pewpil/auris/docs/hw-comparison.md

---
id: hw-comparison
aliases: []
tags: []
---
# Cane — Hardware branch comparison (esp32-s3 / esp32-p4 / raspi-5 / raspi-4)

> **Derived from the four branch tips (2026-09-26)** — `esp32-s3` (`b853b5b`), `raspi-5` (`adade7f`), `esp32-p4` (`490a7fc`), `raspi-4` (`76e8797`) — each carrying its own itemized components-and-pricing exercise over the `agnostic` hardware-open baseline (`5b40cb2`). Purpose: give the co-researcher's purchase-approval sign-off ([README §9](../README.md#9-open-items)) a single comparison artifact across **all** decision variables (cost, heat, power, compute, cameras, link, form — the full set of 27 below), with a 1/0/−1 score matrix: **1 = the branch's wearable board performs well on the variable, 0 = neither good nor poor, −1 = performs poorly** — absolute scores, so several boards can earn 1s together on a row. The branch choice itself is part of the sign-off; this matrix is a decision aid, not the decision.
>
> **Dated research artifact — read with three later decisions.** (i) **The wearable was chosen from this matrix** (2026-10-01) and **purchased on 2026-10-03: a Raspberry Pi 5, 8 GB at ₱6,000**, with the class closed and **no alternative board class carried** ([README §3](../README.md#3-hardware) constraint 4; [hardware.md](hardware.md) §4). The esp32-s3, esp32-p4, and raspi-4 columns below are therefore **the decision record, not a menu of what else could be bought** — they explain why this class won, and they are kept for that reason alone. (ii) **The hardware bench phase was dropped** (2026-10-01, [`bench-tests.md`](bench-tests.md)), so the **gate-weighted view in §2 (rows 5, 6, 7, 15) scores risks that are no longer executed as measurements**: the co-residence, latency, and underrun rows are now P2 cycle-budget arguments, and row 2's bench-phase outlay is no longer spent. This is also the strongest argument that dropping the bench was affordable on this class — the Pi 5's advantage on the compute rows is **architectural** (an A76's margin), not an empirical claim a breadboard would have had to confirm. (iii) **The matrix scored a 4 GB SKU while an 8 GB board was bought.** Its cost rows (1, 3) and its N1/N4/N15 supply figures therefore **slightly understate the executed purchase** — 8 GB costs more than the 4 GB the matrix priced. This does not disturb the ordering the matrix produced (the RAM delta is far too small to move a −9 vs +19 gap), and the decision is now settled by purchase rather than by score; it is recorded here so the matrix is not read as a costing of what was actually bought.

**Comparison boundary.** The pointer and both P5-bound one-time blocks are byte-identical across the four tips (the ESP32-S3 pointer kit — devkit, IMU, time-of-flight module, ultra-wideband tag, buttons, earphones — plus bench infrastructure, harness kits, the printed-marker stock, the carrier-PCB and soldering-service quote lanes). Every difference priced or scored below is the **wearable side**: its compute board, cameras, audio path, and worn power chain.

## 1. Notes table — the facts each matrix score is grounded in

| # | Fact | ESP32-S3 branch | ESP32-P4 branch | Raspberry Pi 5 branch | Raspberry Pi 4 branch |
|---|---|---|---|---|---|
| N1 | Wearable compute chip | ESP32-S3-DevKitC-1, N16R8: 2 cores at 240 MHz (LX7) + vector instructions, 8 MB PSRAM, radio on-chip | ESP32-P4 Function-EV-Board: 2 cores at 400 MHz (RISC-V) + vector instructions, up to 32 MB PSRAM, ESP32-C6 companion module on-board | Raspberry Pi 5, 4 GB RAM: 4 cores at 2.4 GHz (Cortex-A76), runs Linux — **the variant this matrix scored** (4 GB is ample for the wearable's resident workload: two QVGA CV streams, the renderer, the AP, and batch-written logs sit well under ~1 GB; no swap configured). **The board actually purchased (2026-10-03) is the 8 GB SKU of this same class at ₱6,000** — a superset, so this row's compute verdict carries over unchanged while its cost figures do not (see the header note) | Raspberry Pi 4 Model B, 4 GB RAM: 4 cores at 1.5 GHz (Cortex-A72), runs Linux |
| N2 | Software class | microcontroller, no operating system | microcontroller, no operating system | full Linux single-board computer | full Linux single-board computer |
| N3 | Whole-project fixed-price envelope (each branch's committed totals, as scored 2026-09-26 — **not the executed spend**; the actual cart is ≈ ₱21,800–37,300 with ₱6,000 spent, [`purchase-list.md`](purchase-list.md) §9) | ₱9,750–18,150 | ₱11,800–20,450 | ₱23,800–38,500 | ₱15,400–26,600 |
| N4 | Wearable-core cost inside that envelope (board + cameras + audio) | ~₱940–1,590 (second devkit + three OV2640 modules + amp pair) | ~₱4,300–6,700 (evaluation board + three MIPI camera modules + flat-cable spares + amp pair) | ~₱14,000–20,800 (Pi + two Camera Modules 3 Wide + cables + cards + audio sticks) | ~₱6,800–10,500 (Pi + three IMX219 160° modules + cable spares + mandatory heatsink + cards + audio sticks) |
| N5 | Mobile power chain (worn) | protected 18650 cell on a charging/protection board (rear station) | compact 10,000 mAh power bank, 5 V / 2 A out | USB power-delivery bank ≥ 20,000 mAh / 45 W + a 5 V/5 A trigger board + 5 A-rated cables; official 27 W mains supply for the bench only | standard bank, 5 V / 3 A out, ≥ 10 Ah; official 15 W mains supply for the bench only — **no trigger board, no e-marked cables** |
| N6 | Typical sustained draw, render + tracking active | under ~1.5 W | roughly 2–4 W | roughly 5–12 W (the 8 GB SKU sits at the top of this range on memory-side activity; **verify actual draw at the P2 SPICE step and record it**, since runtime on the worn bank depends on it) | roughly 4–6 W |
| N7 | Runtime per charge (worst-case math from each branch's own rows) | 9 Wh cell at ~1 W, duty-cycled → many hours | 37 Wh bank at ~3 W → 10 h + | 74 Wh bank at ~8 W → ~8 h, on the branch's biggest bank | 37 Wh bank at ~5 W → ~6–7 h |
| N8 | Thermal class at the head | cool, no heatsink | warm, no heatsink (larger board area spreads it) | wants a heatsink/active cooler near skin | **heatsink mandatory** (the A72 throttles readily under sustained all-core load) |
| N9 | Boot to first sound | well under a second | well under a second | tens of seconds (Linux boot) plus crash/freeze modes the branch itself flags | tens of seconds (Linux boot) — same Linux class |
| N10 | Camera ports on the board | one (parallel DVP) → cameras alternate; multiplexer question open at the tracking gate | one (MIPI serial lane) → cameras alternate; multiplexer question reopened at the tracking gate | two native MIPI lanes → mux question closed in hardware | one 15-pin MIPI lane → cameras alternate; multiplexer question reopened at the tracking gate |
| N11 | Pinned cameras | OV2640, 160° field of view, ~₱100–200 each, stocked everywhere local | SC2336-class MIPI modules, ~₱300–900 each, fewer local stockists, lens-variant checkout caution | Camera Module 3 Wide official, 120°, autofocus — ₱1,500–3,000 each; distributor currently showing sold-out under a global supply advisory | IMX219 160° modules, ₱500–900 each, multiple confirmed local listings; visible-light only — NoIR/night-vision variants rejected |
| N12 | Radio / link | native Wi-Fi on-chip; link = ESP-NOW (native, no accessory) | no radio on the chip — the on-board C6 companion hosts the access point; data crosses an esp_hosted hop | native Wi-Fi; hosts the access point through Linux networking | native Wi-Fi; hosts the access point through Linux networking |
| N13 | Audio path | two I²S class-D amplifiers → wired jack (literal hardware path) | identical literal I²S path | USB dongle → jack (kernel audio stack in the path) | USB dongle → jack — **the board's native analog jack exists but is deliberately declined** (PWM-derived, hiss/limited SNR) |
| N14 | Board size / on-head mass class | devkit ~25×55 mm; wearable well under ~200 g all-in | evaluation board ~100×70 mm + bank → ~300 g class | 85×56 mm + active cooling + biggest bank → ~450 g+ class | 85×56 mm + heatsink + bank → ~300 g class |
| N15 | Supply-lane health (each branch's own words) | confirmed in stock locally (₱499 devkit) | listed locally but single-shop risk flagged | **resolved by purchase** — the row recorded distributor sold-out at ₱11,449 with a price/lead-time advisory, and the board was in fact obtained locally on 2026-10-03 at **₱6,000** (consistent with a grey import, **no manufacturer warranty**, so the supply risk that remains is DOA replacement rather than availability) | well stocked locally (Circuitrocks same-day Metro Manila, Makerlab, Shopee kits) — listings carry the same global advisory wording |
| N16 | Tracking-tier software stack (camera frames → quad detection → pose solve) | esp32-camera frames; **no OpenCV on ESP-IDF** — the quad detector and pose solve are hand-implemented in C; the ecosystem's nearest stock precedent is a QR-code example (finder-pattern logic, not a fiducial pipeline); the plan's fallbacks (flexible dictionary, detect-then-track) are named mitigations | esp_cam_sensor/ISP frames; **same hand-built detector situation** — no stock fiducial library on ESP-IDF; vector instructions accelerate the inner loops but the code is equally custom | picamera2/legacy frames; **stock `cv2.aruco`** (opencv-contrib) and mature AprilTag libraries — the plan's exact pipeline as standard function calls | picamera2 frames; **stock `cv2.aruco`** — identical library story, with more headroom already counted in row 5 |

## 2. The score matrix (1 performs well / 0 neither / −1 performs poorly)

| # | Variable | ESP32-S3 | ESP32-P4 | RPi 5 | RPi 4 |
|---|---|---|---|---|---|
| 1 | Whole-project cost envelope | 1 | 0 | −1 | 0 |
| 2 | *(retired 2026-10-01)* Formerly "bench-phase outlay — parts that must land before the breadboard phase." **No bench phase runs**, so this row scores a decision nobody has to make any more; kept for the record, it is **excluded** from the column sums' gate-weighted reading | 1 | 0 | −1 | 0 |
| 3 | Wearable-core part cost | 1 | 0 | −1 | 0 |
| 4 | Supply stability on branch-critical rows | 1 | 0 | −1 | 0 |
| 5 | Compute headroom at the render + tag-detection co-residence gate | 0 | 1 | 1 | 1 |
| 6 | Motion-to-sound latency certainty (the 100 ms budget's audio path) | 0 | 1 | −1 | −1 |
| 7 | Render underrun risk (≤ 2 ms per 128-sample audio buffer) | 0 | 1 | −1 | −1 |
| 8 | Boot-to-first-sound time and run reliability | 1 | 1 | −1 | −1 |
| 9 | Heat near the user's head at sustained load | 1 | 1 | −1 | −1 |
| 10 | Thermal-design burden on the printed build | 1 | 0 | −1 | −1 |
| 11 | Mobile-rail weight and bulk on the strap | 1 | 0 | −1 | 0 |
| 12 | Session runtime between charges | 1 | 1 | 0 | 0 |
| 13 | Power-rail complexity | 1 | 1 | −1 | 1 |
| 14 | Recharge turnaround and spare-supply logistics | 1 | 0 | −1 | 0 |
| 15 | Camera capture architecture (ports; mux exposure) | −1 | −1 | 1 | −1 |
| 16 | Camera module price and local availability | 1 | 0 | −1 | 1 |
| 17 | Camera field-of-view fit for the vision tier | 1 | 0 | 1 | 1 |
| 18 | Camera software and driver maturity | 1 | 0 | 1 | 1 |
| 19 | Audio path simplicity and fidelity | 1 | 1 | −1 | 0 |
| 20 | Link implementation risk on the branch's own stack | 1 | −1 | 0 | 0 |
| 21 | Link throughput headroom | 0 | 1 | 1 | 1 |
| 22 | Total on-head weight | 1 | 0 | −1 | 0 |
| 23 | Breadboard-friendliness under the no-solder rule | 1 | −1 | 0 | 0 |
| 24 | Hand-solder carrier fit for the outsourced soldered build | 1 | 0 | 0 | 0 |
| 25 | Fit in the strap-mounted wearable form | 1 | 0 | −1 | −1 |
| 26 | HRTF rendering capacity and quality-building headroom | 0 | 1 | 1 | 1 |
| 27 | Pointer-tracking (ArUco/AprilTag) detection-software readiness on the branch's own stack | 0 | 0 | 1 | 1 |
| | **Column sums** | **+19** | **+7** | **−9** | **+1** |

Gate-weighted view — doubling the four rows where a bench gate can actually fail (rows 5, 6, 7, 15): **ESP32-S3 +18, ESP32-P4 +9, RPi 5 −9, RPi 4 −1** (row 27 stays single — doubling it would re-count row 5's content). The ordering is stable under both weightings (S3 > P4 > RPi 4 > RPi 5). Worth saying out loud: the raspi-4 branch is the only one whose gate-weighted score falls *below its own unweighted score* — from +1 to −1 — while the S3 barely moves (19 → 18), the P4 rises (7 → 9), and the RPi 5 is unchanged (−9 → −9): four of the Pi 4's weaknesses sit directly on gate-touching rows (latency, underruns, the reopened mux, and heat feeding the thermal gate), and its two native-camera-port advantage is absent — at a much lower price than the RPi 5, but the price advantage does not convert into gate safety.

## 3. Explanation of each variable

1. **Whole-project cost envelope** — each branch's committed fixed-price total from its purchase list (notes row N3). Scored by where the envelope sits, not by a relative race: S3's sits comfortably low (+1), the P4's and the Pi 4's are reasonable middles (0 each — the Pi 4 clearly above the P4, both clearly below the S3), the Pi 5's is more than double the S3's (−1). *Post-purchase note (2026-10-03): the executed cart is ≈ ₱21,800–37,300 with the compute board bought at ₱6,000, so the envelope as actually spent sits **below** this scored range at the low end — the −1 still stands as the matrix's judgement of the class on 2026-09-26, but it should not be read as a costing of what was bought.*
2. **Formerly "bench-phase outlay" (retired 2026-10-01)** — what must be spent up front for the breadboard phase. With no bench phase this row is **historical**: the scored ordering (a ₱500 devkit well, the Pi 5's 45 W supply-class kit poorly) remains a true statement about up-front outlay under a hardware-first plan, but the project no longer runs one. Recorded, not used.
3. **Wearable-core part cost** — the only part of the bill that differs by branch (notes N4). Same scoring logic: the microcontroller-class cores score well or neutral; the Pi 4's ~₱6.8–10.5k is half the Pi 5's but 4–5× the S3's → 0.
4. **Supply stability** — how risky the branch-critical rows are to buy today under the plan's local-lane purchasing rule: S3 confirmed in stock locally (+1); P4 listed but its own document flags single-shop risk (0); the Pi 5's official distributor is currently showing sold-out with an explicit supply advisory (−1); the Pi 4 is genuinely well stocked on multiple local lanes, with only boilerplate advisory wording → 0. *Post-purchase note (2026-10-03): the Pi 5's −1 was **resolved in fact** — the board was obtained locally at ₱6,000 — but it converted into a different exposure: a grey import carries **no manufacturer warranty**, so the residual risk is DOA replacement rather than availability ([README §3](../README.md#3-hardware) constraint 3, [§7](../README.md#7-risks-and-limitations) risk 12).*
5. **Compute headroom at the co-residence gate** — the Phase 2 bench test 7 makes the audio renderer and the camera-vision pointer tracker share one chip. S3: expected to pass, but the margin is exactly what the plan's risk 8 worries about → 0. P4 (400 MHz, up to 32 MB PSRAM), R5 (Linux + OpenCV-class compute), and the Pi 4 (4× A72 + Linux) all carry genuinely comfortable margins (+1 each). The detection-software dimension is separated into row 27; this row stays on raw margin.
6. **Motion-to-sound latency certainty** — the plan's absolute 100 ms motion-to-sound target, of which ≤ 2 ms is the per-audio-buffer render row. S3: literal hardware path, but the margin must be proven on the bench — scored 0 (unguaranteed, unthreatened). P4: literal path and more margin → 1. R5 and the Pi 4: a kernel scheduler sits in the audio path — the raspi-5 branch names Linux audio jitter as its real exposure, and the raspi-4 branch inherits exactly the same Linux class → −1 each.
7. **Render underrun risk** — the same render row from the failure side: buffer underruns make the sound stutter. Scoring mirrors row 6 for all four branches.
8. **Boot and run reliability** — participants in the Phase 5 study put this on their heads: S3 and P4 power on into the sound in under a second with no operating system to freeze (+1 each); both Pi branches take tens of seconds and introduce crash/silent-failure modes → −1 each.
9. **Heat at the head** — sustained render + camera load next to skin. Both microcontroller-class boards run cool without heatsinks (+1 each); both Linux boards want cooling near the user's face — the Pi 4 most of all, since its branch makes the heatsink mandatory outright → −1 each.
10. **Thermal-design burden on the printed build** — how much the enclosed, service-soldered Phase 3 housing must engineer airflow: none needed for S3 (+1); mild vent/area planning for the bigger P4 board (0); deliberate thermal design for both Pi branches — the raspi-4 branch's own text calls it a stronger duty than the raspi-5's A76 → −1 each.
11. **Mobile-rail weight and bulk** — the worn supply's mass: small protected cell (+1); pocket banks on P4 and Pi 4 (0 each); a delivery-grade 45 W bank plus trigger board and heavy-rated cables on the Pi 5 (−1).
12. **Session runtime** — stored energy versus draw: S3's small cell with duty-cycled draw lasts long (+1); P4's bank dwarfs its gentle draw (+1); both Pi branches net out ordinary — the Pi 5 from a very large bank against a heavy draw (0), the Pi 4 from a mid bank against a mid draw (0).
13. **Power-rail complexity** — how many negotiated-contract/delicate-cable mechanisms sit between battery and chip: S3's protected-cell chain (+1); P4's plain 5 V bank feed (+1); the Pi 4's plain 5 V/3 A contract — the branch's own words: the raspi-5 branch's most tangled block simply does not exist here (+1); the Pi 5's 5 V/5 A contract, which fails into throttling and needs a power-delivery trigger board and e-marked 5 A cables → −1.
14. **Recharge turnaround** — S3's small cell recharges quickly and cheaply to duplicate (+1); P4's swappable bank and the Pi 4's swappable bank (0 each); the Pi 5's multi-hour 20,000 mAh bank recharge (−1).
15. **Camera capture architecture** — how many native camera ports the board has: S3 has one (−1), P4 has one (−1), and the Pi 4 has one (−1) → all three leave the multiplex/alternation decision to the tracking gate at bench test 7, while the Pi 5's two native lanes close the question in hardware (+1). This is the row where the P4's and Pi 4's compute surplus is spent buying back a problem the S3 branch also carries — and on the Pi 4 it is the reopened risk the branch itself flags.
16. **Camera price and availability** — OV2640 modules cost ~₱100–200 each everywhere (+1); SC2336-class is available with fewer stockists and a lens-variant caution (0); the official Camera Module 3 Wide is 3–4× the price with shaky distributor stock → −1; the IMX219 160° modules sit at ₱500–900 each across **many confirmed local listings** — the availability term is strong enough to score +1 despite the mid price.
17. **Field-of-view fit** — 160° modules on S3 (+1) and 160° modules on the Pi 4 (+1 — the widest of the four); the P4's pinned sensor class lists narrow lenses by default, wide variants needing checkout care (0); the Pi 5's official 120° wide camera is a clean fit (+1).
18. **Camera software maturity** — the S3's camera driver and detection examples are the most trodden path in the Espressif ecosystem (+1); the P4's sensor support is in-tree but newer (0); on the Pi side the IMX219 is the longest-supported Raspberry Pi camera — mature drivers and a decade of examples (+1), and the Pi 5's official stack is likewise mature (+1).
19. **Audio path simplicity** — S3 and P4 both take the plan-native literal digital-audio-into-amplifier route into the mandatory wired jack (+1 each); the Pi 5's USB-dongle detour is **forced** (no analog output exists) → −1; the Pi 4's dongle path is a **consciously chosen** detour — the board's native jack exists and is declined for signal-to-noise and cross-branch consistency, so the fidelity term is fine and the complexity is a deliberate, documented trade → 0.
20. **Link implementation risk** — S3's ESP-NOW is native and abundant in examples (+1); the P4's answer — an on-board companion chip bridged by esp_hosted glue — is functional but is exactly the hop its own document flags for verification (−1); both Pi branches run the standard Linux access-point pattern, unremarkable (0 each).
21. **Link throughput headroom** — ESP-NOW suits today's small payloads but little more (0); the Wi-Fi-6 companion (+1) and both full Linux network stacks (+1, +1) leave room to grow.
22. **Total on-head weight** — the wearer carries everything: S3 well under ~200 g (+1); P4 and Pi 4 land in the ~300 g class with their banks (0 each — the Pi 4 trades the P4's big board for its heatsink); R5 goes past ~450 g with its cooler and biggest bank (−1).
23. **Breadboard-friendliness** — the Phase 2 rule forbids soldering: the S3 devkit is all header rows (+1); the P4 evaluation board is connector-saturated (serial-camera and flat-flex interfaces dominate) → −1; both Pi branches expose a 40-pin header workable with common cobbler adapters (0 each).
24. **Hand-solder carrier fit** — the Phase 3 build is outsourced to a local hand-solder service with carrier boards designed through-hole-dominant ([`assembly.md`](assembly.md) binds this): the S3 fits that bind perfectly (+1); on P4, R5, and the Pi 4 the compute board itself is a connector-saturated module that mounts as a unit, and the flat-flex/ribbon camera world sits at the edge of what a hand-solder shop wants — the harness work still applies to all four, but the carrier story is simplest on S3 (0, 0, 0).
25. **Strap-form fit** — the resolved form factor is an elastic strap with printed mounts, not a helmet: a credit-card-plus devkit vanishes into a mount (+1); the P4's evaluation board rides mid-strap, bulky but practical (0); both Pi boards are 85×56 mm slabs — the Pi 5 plus cooler plus the biggest bank is the least consistent with the form (−1), and the Pi 4 plus mandatory heatsink repeats the same structural mismatch with a lighter bank (−1).
26. **HRTF rendering capacity and quality-building headroom** — spatialized rendering is the product (`renderer`: generic HRTF azimuth, 48 kHz buffers under the ≤ 2 ms-per-buffer row), and the plan deliberately keeps the workload modest (elevation is carried by the carrier-pitch cue, not spectral HRTF — the plan's risk 3). All four run the planned HRTF; this variable scores what the chip can afford **beyond** that while sharing duty with vision: longer impulse responses and denser azimuth grids (the real levers on rendering quality), and eventually per-participant measured HRTF sets. S3: planned route fits inside the budget, but upgrade headroom while co-residing with detection is bounded, and measured-HRTF work is out of its class → 0. P4: vector instructions plus PSRAM tables afford longer filters and denser grids alongside CV duty (+1). Both Pi branches: CPU to burn for research-grade binaural work (+1 each). This is the one row where branch choice most directly touches the study's perceptual outcomes (the localization metrics) — a genuine plus for the three high-compute branches even though the thesis plan specifies the modest, robust route; worth putting before the co-researcher at sign-off rather than burying.
27. **Pointer-tracking (ArUco/AprilTag) detection-software readiness** — the vision tier's path from camera frames to quad detection to the pose solve that turns the printed marker's known physical size into bearing and range ([README §2.5](../README.md#25-pointer-tracking-stack-vision-uwb-imu), [§3.8](#38-pointer-tracking-hardware--notes--contingencies)). The row deliberately does **not** re-score raw compute margin (row 5), camera port count (row 15), or capture-driver maturity (row 18) — it isolates the one thing they do not say: whether the tracker is a library call or hand-built engineering. S3 and P4: no OpenCV exists on ESP-IDF, so the quad detector and the pose solve are hand-implemented in embedded C — the ecosystem's nearest stock precedent is a QR-code example (finder-pattern logic, not a fiducial pipeline); feasible, and the plan's own designed route (the marker decision explicitly moved the cost from hardware to compute), but custom engineering that must land inside the co-residence budget → 0 each; scoring S3 lower than P4 here would double-count row 5's margin. Both Pi branches: `cv2.aruco` (opencv-contrib) and mature AprilTag libraries make the plan's exact pipeline standard function calls on `picamera2` frames → +1 each. The row's honest message: **on the two Linux branches the vision tier is configuration; on the two microcontroller branches it is a build item** — where the tier's schedule risk lives before the pre-oral defense, mitigated by the plan's named fallbacks (flexible dictionary choice, the detect-then-track scheme, QVGA mono frames) rather than eliminated.

## 4. Reading the result

- **Unweighted: ESP32-S3 +19, ESP32-P4 +7, Raspberry Pi 4 +1, Raspberry Pi 5 −9.** Gate-weighted (rows 5, 6, 7, 15 doubled; row 27 single): **S3 +18, P4 +9, RPi 4 −1, RPi 5 −9** — the ordering survives both weightings, with one nuance: gate-weighting *lowers* the Pi 4 below zero (four of its weaknesses sit on gate-touching rows) while leaving the Pi 5 unchanged (its two native camera ports buy back one gate row), so the two Linux branches converge under stress — the Pi 4's price advantage does not convert into gate safety.
- **The tracking tier's software dimension is now explicit (row 27)**: on the two Linux branches the ArUco/AprilTag pointer tracker is a stock library call; on the two microcontroller branches it is a hand-built detection-and-pose pipeline (no OpenCV on ESP-IDF) that must be validated inside the co-residence gate — the strongest single argument for the high-compute branches once the HRTF row is on the table, with the plan's named fallbacks (flexible dictionary, detect-then-track, QVGA mono frames) mitigating rather than eliminating that schedule exposure.
- The corrected scoring semantics sharpen the story: the S3 leads not because the P4 is bad — its co-residence, heat, runtime, audio, power-simplicity, and HRTF-headroom scores are all genuinely +1 — but because the S3 wins or ties on nearly everything while being the cheapest at the head and in the pocket. The P4's honest deficit list is short and specific: one camera port, the companion-chip link hop, flat-cable-heavy bench ergonomics, thin supply lanes. The raspi-4 branch nets to exactly zero — it inherits the Linux class's structural costs (kernel-in-the-audio-path, heat with a mandatory heatsink, boot exposure, the single camera port, the slab form) while shedding the Pi 5's power-rail complexity and a third of its price, and it buys back camera availability with the IMX219 pair — the trade is real, but it nets to neither good nor poor. The Raspberry Pi 5's deficits — power, heat on the head, weight, boot/latency exposure, price — remain structural to the computing class, which is exactly what a head-mounted device cannot buy back with headroom.
- The matrix is a prior, not a verdict — and the referee changed shape twice: the bench gates it weighted (render tests, tracking co-residence) are no longer executed as measurements, so the chosen board is defended on **architectural** margin plus P4/P5 in-use observation; and the board is now **purchased** — the **Raspberry Pi 5, 8 GB** wearable (bought 2026-10-03, ₱6,000; [README §3](../README.md#3-hardware), [§9](../README.md#9-open-items)), with the class closed and **no alternative carried** ([`hardware.md`](hardware.md) §4). The matrix scored a 4 GB SKU, so its cost rows understate the actual spend by the 8 GB delta. Prices were point-in-time and the ultra-wideband module's single-shop risk applies to all four equally, so it scores nowhere.

## 5. Provenance and upkeep

Derived read-only from the committed state of the four branch tips on 2026-09-26 (`esp32-s3` @ `b853b5b`, `raspi-5` @ `adade7f`, `esp32-p4` @ `490a7fc`, `raspi-4` @ `76e8797`, baseline `agnostic` @ `5b40cb2`); scores are judgments over those tips' committed purchase lists and README selections, not new facts. Row 27 is scored from the same tips — the tracking design (the marker scheme, [README §2.5](../README.md#25-pointer-tracking-stack-vision-uwb-imu)) is plan-level text identical across them, so no tip change accompanies that row. If a branch tip changes (prices re-verified, a part swapped), re-derive the affected rows from that tip and bump the date here. The matrix is the standing scoring basis behind the **decision** (the purchased Raspberry Pi 5, 8 GB wearable) and is refuted only by observation on the built device (P4/P5), never superseded by a paper decision — and, since the 2026-10-03 purchase, not by a re-costing either. Any tip-priced row is re-verified at checkout under the current purchase lanes ([README §9](../README.md#9-open-items)).
