pewpil/auris/.opencode/concept.md

# Cane — Concept

The canonical concept statement lives in the project [`README.md`](../README.md) — [§1 Concept](../README.md#1-concept) (user, equipment, and the laser-hit → egocentric-sound interaction rule), with the system architecture in [§2](../README.md#2-system-overview).

Raw requirements and the worked concept examples remain in [`new.md`](new.md). This stub is session context only and must be kept consistent with `README.md`; edit the README, not this file.
