pewpil/auris/auris/tools/bringup/bringup-log.md

# Raspberry Pi bring-up snapshot

Last confirmed: 2026-11-07 12:01 Asia/Manila. This is a dated observation, not a claim that the hardware state will remain unchanged.

## Working path

The Pi dashboard process `auris.service` is enabled and active on `capstone`; its `/state` endpoint reports `mock: false`. The unit uses `Restart=always`, is wanted by `default.target`, and the user manager has `Linger=yes`, so the local dashboard starts at boot and restarts after process failure. The PC can reach the live endpoint over direct Ethernet at `http://192.168.77.2:8081/state` when requests bind to PC address `192.168.77.1`, with observed fetch times around 60–65 ms.

The pointer path is producing a changing orientation matrix and ToF readings around 1.85 m. The trigger state is readable. Earlier direct requests took around 60–65 ms; the latest local-proxy browser sample took 5.7 ms. The terminal views in this directory show the same live snapshot.

At 01:57, the local Ethernet proxy at `http://127.0.0.1:8781/` returned the dashboard and live state with HTTP 200; the state fetch took 110 ms and reported `mock: false`, ToF 1.853 m, and 55,954 camera frames.

The Pi camera is capturing 640×480 frames. At 02:26 the state counter was 1,503 frames after the service restarted, with zero accepted cube-pose frames and zero read failures. Earlier browser brightness samples were below 1/255, so the current preview has not provided usable tag detections.

At 02:31, the Windows browser showed a live pointer-only snapshot over the Ethernet proxy: ToF 1.852 m, camera 6,948 frames at an estimated 23.2 fps, zero accepted detections, 62.9 ms frame-read time, 2.7 ms detect time, and zero read failures. The browser’s downsampled camera brightness was 0.2/255, so the immediate tracking blocker is an almost-black image rather than slow ArUco processing; the exact cause (cover, aim, exposure, or lighting) is not distinguishable remotely. The page reported no head IMU sample. The stereo-pan display was also corrected locally from a degree-like value to a normalized left/center/right percentage bar.

A read-only watcher was originally started as PID 32815 until approximately 09:50 Asia/Manila, polling `/state` every 30 seconds. At 03:10 it had written 158 snapshots with zero poll errors. Its script is `/home/user/auris_telemetry_watch.py`, output is `/home/user/auris-bringup-watch-20261107.jsonl`, and stderr/stdout are in `/home/user/auris-telemetry-watch.log`; it is a low-rate bring-up history rather than study instrumentation, and it does not restart after a Pi reboot.

A read-only `@STATUS` query over the pointer USB console reported `boot=81 reset=1(power-on) cal=1 imu=1 tof=1 link=1`; the stored accelerometer offsets were `(0.4465, 0.3448, -1.4822) g` and gyro bias `(-2.069, -3.823, -0.713) deg/s`. Calibration is valid, so do not rerun `@CAL` as a drift fix; the status command's `link=1` means firmware link readiness and is not an acknowledgement from the Pi. The serial-console session coincided with this power-on boot and may have reset the node while opening the port. `auris.service` was restarted afterward, reports `NRestarts=0`, and local/public `/health` returned `ok`; local and public `/camera` both returned HTTP 200 `multipart/x-mixed-replace` after restart, with the stream reads deliberately capped at two seconds.

An analysis of the first 50 snapshots from 01:52:39 to 02:16:43 found a +230.7° unwrapped yaw change, about +9.58°/min, while roll/pitch each varied by less than 0.01° at recorded precision and ToF stayed between 1.851 and 1.859 m. If the pointer remained physically still, this pattern is consistent with gyro yaw bias; the device's physical pose was not independently observed, so it is not a confirmed drift or accuracy measurement. The current `/state` does not expose the firmware calibration flag. The pointer firmware notes explain that yaw has no magnetometer reference and accumulates residual gyro bias.

The dashboard and MJPEG camera routes returned HTTP 200, and the camera route returned `multipart/x-mixed-replace`. A temporary public Cloudflare tunnel was active at the time of this snapshot; its current URL and expiry belong in the operator session because the URL rotates and expires.

The approved temporary public tunnel was restarted at 01:59 and returned HTTP 200 for `/health`; its `/state` response also reported `mock: false`, and `/camera` returned HTTP 200 with `multipart/x-mixed-replace`. The current URL is in the operator session and the 8-hour runtime expires around 09:59. The tunnel unit is `static`, not enabled, and has `Restart=no`; it does not auto-start after reboot. The local dashboard unit remains enabled independently.

At 02:43, the watcher’s 103 valid snapshots from 01:52:39 to 02:43:13 had zero poll errors, zero fresh head-IMU samples, zero accepted camera poses, zero camera read failures, and `default` as the placement baseline in every row. Pointer ToF stayed between 1.850 and 1.860 m; camera read time had a 63.0 ms median and detection time a 2.7 ms median. These samples establish that the feed and camera loop are staying alive, but do not establish pointer motion accuracy or stillness.

At 02:45, `3d/index.html` and `3d/viz.js` were deployed to `/home/user/Projects/3d` over the already-open SSH session after a new Windows SSH connection timed out. Their SHA-256 hashes matched the workspace files and the Pi service remained active with zero systemd restarts. A fresh browser page loaded through the local Ethernet proxy and showed live state; its fetch sample was 14.4 ms. The temporary public tunnel also returned `/health: ok` and `/state` with `mock: false`, ToF 1.854 m, 19,019 camera frames, zero detections, no fresh head IMU, and the `default` baseline. A single browser fetch time is only a spot observation, not a latency distribution.

The PC terminal views now format normalized stereo pan as `L n%`, `Center`, or `R n%`, matching the dashboard’s new center-out bar; they remain read-only views of `/state`.

At 02:48, V4L2 reported 640×480 MJPEG capture at 30 fps, auto-exposure mode `Aperture Priority`, automatic white balance enabled, and continuous autofocus enabled. These settings do not show a manually fixed short exposure; the almost-black image is more consistent with the camera’s view or light level, although remote telemetry cannot rule out camera hardware or driver behaviour.

The installed CLI accepts a camera calibration JSON file and defaults to `calibration.json`; no calibration JSON was found in the service working directory or dashboard directory, and `/state` reports `calibration_source: assumed-fov`. The current camera pose path is therefore running without a confirmed intrinsic calibration, so its metric pose accuracy remains unestablished even after a tag becomes visible.

The last 10 watcher rows from 02:49:13 through 02:53:43 showed 456–463 additional camera frames per 30 seconds, about 15.3 frames per second, while V4L2 reported a configured 30 fps. The camera-read field stayed near 63 ms and detection near 2.7–2.9 ms. This makes capture cadence the likely software-side bottleneck in this interval; the earlier single-second browser estimate of 23.2 fps was too short to represent this sustained rate, so the page now averages its display over five seconds.

At 02:57, the five-second camera-rate estimator and a versioned `viz.js` module URL were deployed to the Pi. The Pi served the same `viz.js` SHA-256 as the workspace over both local HTTP and the public tunnel; the Pi service remained active and `/health` returned `ok`. This smooths the displayed rate only and does not raise the camera’s measured capture cadence.

At 02:59, the Pi reported load average 0.42, 95.1% aggregate CPU idle, a 50.7 °C thermal-zone reading, and `vcgencmd get_throttled` equal to `0x0`. This point-in-time sample showed no thermal or under-voltage throttle and little whole-system load while camera reads remained near 63 ms. The dark-frame hint now tells the operator to uncover the camera, add light, and aim at a close cube tag.

At 03:01, the revised dark-frame hint was confirmed in both the Pi’s local page and the temporary public page. `auris.service` and `auris-tunnel.service` were active, and the Pi’s `/health` returned `ok`.

At 03:04, 20 consecutive pointer snapshots from 02:54:43 to 03:04:13 showed +97.2° unwrapped yaw change (about +10.23°/min), roll span 0.10°, pitch span 0.00°, and ToF 1.851–1.859 m. If the pointer remained still, this is consistent with residual gyro yaw bias; no independent pose observation proves stillness, so the change remains ambiguous between drift and real motion. No recalibration was attempted because the stored pointer calibration is valid.

At 03:07, the current USB inventory again showed the Sunplus UVC camera and one Silicon Labs CP210x USB serial bridge at `/dev/ttyUSB0`; `/dev/serial/by-id` had one entry and no second USB serial node was enumerated. The Pi exposes I²C buses 1, 13, and 14. This confirms the current device enumeration but does not identify the head IMU or rule out a non-USB wired path.

At 03:10, Linux sysfs listed I²C bus 1 but no instantiated client or driver metadata for `1-002d`, so the earlier `0x2d` bus scan result remains unidentified. The 158 watcher rows from 01:52:39 to 03:10:43 had zero poll errors, zero fresh head samples, zero camera-pose samples, zero camera read failures, pointer ToF 1.850–1.860 m, median camera read time 63.0 ms, and median detection time 2.7 ms.

At 03:11, the latest 20 pointer snapshots from 03:02:13 to 03:11:43 showed +92.7° unwrapped yaw change (about +9.76°/min), roll span 0.10°, pitch span 0.00°, and ToF 1.850–1.859 m. The rate resembles the earlier apparent drift, but without an independent physical pose observation it remains conditional and does not justify changing the valid calibration.

At 03:18, the browser poller was changed from a fixed 50 ms wait after each response to a 50 ms target start-to-start interval, subtracting the request and response duration while keeping one request in flight. The updated `viz.js` and cache-busted `index.html` were copied to `/home/user/Projects/3d`; local and Pi SHA-256 hashes matched, `/health` returned `ok`, `/state` remained `mock: false`, and the public tunnel still returned `ok`. No sensor service was restarted.

At 03:20, the existing Windows Chrome Ethernet-proxy tab showed a live dashboard with a 5.7 ms fetch RTT, ToF at 1.852 m, a released pointer trigger, and pointer orientation populated. The camera counter was 53,012 with a browser estimate of 16.3 fps, latest read/detection times of 62.1/2.8 ms, zero accepted detections, and approximate brightness 0.2/255. Head orientation remained `no data`, camera calibration remained `assumed-fov`, the placement baseline remained `assumed origin`, and audio remained muted. This confirms a responsive local display and live pointer feed, not validated pose accuracy or a usable camera image.

At 03:23, the latest 20 in-use telemetry rows spanning 9.5 minutes showed a 15.34 fps camera-counter rate, zero fresh head samples, zero accepted camera poses, zero frame-read failures, ToF between 1.850 and 1.858 m, median camera-read time 62.95 ms, and median detection time 2.77 ms. The public tunnel served the newly deployed cache-busted `viz.js` with the same SHA-256 as the workspace and its `/state` still reported `mock: false`, ToF 1.857 m, no fresh head sample, and zero detections.

At 03:26, the read-only watcher was restarted with the same output file and a fresh eight-hour duration, so it now appends one `/state` snapshot every 30 seconds until about 11:26 Asia/Manila. The new process is PID 208050; `auris.service` and `auris-tunnel.service` remain active, and `auris.service` remains enabled. Its first appended snapshot reported `mock: false`, ToF 1.856 m, no fresh head sample, zero accepted detections, and no camera read failures.

At 03:29, the temporary public tunnel was renewed so it remains available for the full sleep window; the new quick-tunnel URL expires around 11:29 Asia/Manila and is provided in the operator session rather than stored here. Its `/health` returned `ok`, `/state` remained `mock: false` with ToF 1.852 m, and the cache-busted `viz.js` hash matched the workspace copy. The local dashboard process and its Ethernet route were not restarted.

At 03:42, the refreshed Ethernet dashboard showed an observed 26.0 Hz `/state` update cadence over its rolling window and a latest 44.5 ms fetch duration. A 25-request Pi-loopback sample measured 0.37 ms median, 0.62 ms p95 and 18.67 ms maximum for `/state`; this isolates the local API path, not the Windows Ethernet/proxy path. The UI now reports “Fetch time / update rate” because its timer includes JSON parsing and is not a pure network RTT. The watcher’s latest row reported camera frame 71,101, zero detections, no fresh head sample, no camera read failures, ToF 1.852 m, and 63.03/2.66 ms camera-read/detection times. The renewed public tunnel and local service both remained healthy.

At 03:46, the dashboard’s 20 ms target and five-second observed-rate display were deployed to the Pi and served with matching workspace hashes over local and public URLs. After a Chrome reload through the Ethernet proxy, the page showed 30.7 ms fetch-and-parse time and 25.2 Hz observed poll cadence; this is one page sample, so it does not establish a sustained rate. The 25-call Pi-loopback API sample was much faster than the browser-path sample, so the remaining delay is outside the local `/state` handler, but the exact contribution of the Windows proxy, Ethernet path and browser is not isolated. Live state remained real (`mock: false`), with pointer/ToF at 1.854–1.855 m, camera counter 75,238, zero detections, zero read failures and no fresh head sample. Both Pi user services remained active, and the eight-hour watcher continued as PID 208050.

At 03:49, the latest 20 watcher rows spanning 9.5 minutes showed a 15.31 fps camera-counter rate, zero fresh head samples, zero accepted camera poses, zero read failures, ToF between 1.851 and 1.859 m, median camera-read time 62.68 ms, and median detection time 2.70 ms. The camera cadence is stable in this window, but no useful visual pose is available because the image remains nearly black and no marker is being accepted.

At 03:51, a read-only V4L2 query showed automatic exposure (`Aperture Priority Mode`), automatic white balance, continuous autofocus, brightness at its default value, and 640×480 MJPEG configured for 30 fps; the exposure-time control is inactive under automatic exposure. In-use brightness remains about 0.2/255 with no detections, while camera reads are around 63 ms and report zero failures. No camera controls were changed because the dark scene does not provide a valid target for exposure tuning, and the telemetry cannot distinguish a covered lens from a dark view or driver behaviour.

At 03:54, the same eight-hour watcher process (PID 208050) was still alive after a one-minute wait; `auris.service` and `auris-tunnel.service` remained active and the renewed public `/health` returned `ok`. Its latest snapshot reported `mock: false`, ToF 1.852 m, camera frame 82,129, zero detections, zero read failures, and no fresh head sample.

At 03:55, a read-only device-enumeration check again found the Sunplus UVC camera and only one Silicon Labs CP210x USB serial interface (`/dev/ttyUSB0`). I²C buses 1, 13 and 14 exist, but sysfs lists only the bus adapters and no instantiated sensor client; this does not rule out an unenumerated bridge path, but it gives no new evidence to select `--head-source i2c` or `serial`.

## Missing sensor feeds

The head stream is not present in `/state` (`head.fresh` is false and Euler angles are null). The active service explicitly uses `--head-source none`, so it does not attempt to read the head device. The installed CLI documents `--head-source i2c` as an MPU6050 on Pi I²C bus 1 at `0x68` by default, and `--head-source serial` as `H1` samples from the ESP-NOW bridge. Neither path should be selected until the attached sensor and its data path are identified.

The Pi enumerates one CP2102 USB serial interface at `/dev/ttyUSB0`; it does not enumerate a `/dev/ttyACM*` device. I²C bus 1 reports one responder at `0x2d`; this does not identify an MPU6050 at `0x68` (or `0x69` if AD0 is high), so the head part remains unknown. Buses 13 and 14 had no responders.

The active Pi service runs at 115200 baud and currently produces pointer data, while the installed CLI documents 460800 baud for the P1/H1 bridge stream. The existing pointer USB table works at the current setting. Keep it unchanged until the bridge is confirmed to emit P1/H1; changing only the Pi baud would break the working pointer feed.

The service currently uses `--audio null`, so the dashboard is intentionally silent while head orientation and camera pose are missing.

## Next physical actions

Uncover and aim the camera at one of the cube’s 30 mm ArUco faces in bright, even light; then check for an advancing accepted-pose count and a fresh cube pose in the dashboard.

After the image is usable, provide a valid camera calibration JSON and confirm `/state` reports a calibration source other than `assumed-fov` before treating the cube pose as metric.

Once tag visibility and calibration are established, investigate the sustained capture rate against the advertised 30 fps while preserving the current 640×480 resolution until the 30 mm tags’ legibility is known.

Identify the head IMU breakout and its wiring to the compute unit or bridge. Confirm its part number and data path before selecting a head source or changing serial settings.

For pointer yaw stability, calibration is already confirmed valid (`cal=1`). The remaining limitation is yaw observability: the pointer has no magnetometer, and its `@STATUS` gyro bias is not zero; camera reacquisition must provide the absolute correction when tags become visible. Do not rerun `@CAL` without evidence that the stored calibration is invalid.

After the bridge firmware is updated, switch the Pi parser and baud together to the documented P1/H1 stream and confirm both streams arrive before enabling inertial fallback or audio output.

At 04:01 Asia/Manila, both `auris.service` and `auris-tunnel.service` were active as user services; the system-wide `systemctl` view was inactive, which is expected for these user units. The live API reported `mock: false`, a real pointer matrix and ToF range of 1.854 m, no fresh head sample, camera frame counter 89,043, zero accepted detections, zero read failures, and a latest 31.1 ms camera read. The telemetry watcher remained alive as PID 208050.

The targeted Pi I²C scan found no responders at `0x68` or `0x69`. This does not test the pointer MPU6050: the documented pointer GY-521 is connected to the pointer ESP32's own GPIO21/GPIO22 bus alongside its ToF sensor, and that local bus does not appear on the Pi's I²C adapter. The head IMU has a separate, still-unidentified route to the compute unit; do not interpret the Pi scan as proof about the pointer IMU.

The currently running compute-unit process reads the pointer through one CP210x USB serial device at 115200 baud, and `/state` identifies the active feed as `pointer-usb-table`. This confirms the live USB table path but does not confirm the intended pointer-to-bridge ESP-NOW `P1` path or a head `H1` stream; the installed runtime's P1/H1 bridge mode uses 460800 baud. Keep the working 115200 path unchanged until the bridge and transmitter are physically identified.

At 04:12 Asia/Manila, I deployed a pointer input-source field to the Pi dashboard and made an omitted API source visibly amber as `source not reported`; this avoids presenting an unverified USB or bridge identity as fact. The live `/state` currently has no `source` key, while the service command line configures one CP210x serial path at 115200 baud. The updated Pi page and module served the expected cache key and warning branch, their hashes matched the workspace (after normalizing the JavaScript file's line endings), `/health` returned `ok`, and the user services remained active without restarting the sensor process. The latest read was real (`mock: false`), ToF 1.855 m, head freshness false, camera counter 98,854, zero detections, and zero read failures.

At 04:13 Asia/Manila, the temporary public tunnel also served the updated dashboard page and module; its `/health` returned `ok` and `/state` still reported live pointer/ToF data (`mock: false`, 1.853 m), no fresh head sample, camera frame counter 99,509, and zero accepted detections. The eight-hour watcher remained alive as PID 208050 after 45 minutes.

At 04:16 Asia/Manila, I restarted the existing temporary quick-tunnel user service, which extends its eight-hour runtime to about 12:16 so the public dashboard remains available through the expected wake time. The replacement link passed public `/health`, page, module and `/state` checks; the page contained the source-availability warning and live state remained `mock: false`, with ToF at 1.850 m, no fresh head sample, camera frame counter 100,335 and zero detections. The local sensor service was not restarted.

At 04:18 Asia/Manila, the latest 13 watcher samples spanning six minutes measured a 15.3 fps camera-counter rate, zero frame-read failures, zero accepted tags, no fresh head sample, and ToF at 1.854 m. This confirms the recent camera-frame count continues advancing at the earlier observed rate; it still does not establish image usability or metric pose accuracy.

At 04:29 Asia/Manila, I decoded one actual MJPEG frame from the Pi camera endpoint at 640×480. Its grayscale mean was 0.48/255 (minimum 0, maximum 149); the camera counter continued at about 15.3 fps across the surrounding six-minute watcher window, with no frame-read errors. The near-black image explains the zero detections more directly than a frozen camera does, but brightness alone cannot distinguish a covered lens from a very dark view, so I left exposure controls unchanged.

At 04:32 Asia/Manila, the open Windows Chrome dashboard at `http://127.0.0.1:8781/` was still receiving live Pi data through the local Ethernet proxy: ToF 1.854 m, camera counter 118,014 at roughly 15.4 fps, zero detections, zero reported frame failures, no head orientation, and approximate image brightness 0.2/255. The visible page still had the older `HTTP fetch RTT` label and lacked the new pointer-source row, so its tab has not loaded the latest workspace assets. The Windows screenshot showed the lock screen; I stopped browser interaction and left the live tab untouched. Reload that tab after unlocking Windows to see the updated page.

At 04:33 Asia/Manila, startup configuration inspection showed `auris.service` is enabled and the `user` account has systemd lingering enabled, so the compute-unit service is configured to start independently of an interactive login. The temporary tunnel unit is `static` rather than enabled for boot, which keeps the eight-hour public link an operator-started session; its active runtime remains healthy.

At 04:38 Asia/Manila, the last 120 watcher rows spanning 59.5 minutes contained zero poll errors, zero fresh head samples, zero accepted camera poses, zero camera read failures, and a 15.31 fps camera-counter rate. Pointer data was present in all 120 rows; ToF ranged from 1.849 to 1.859 m and the trigger stayed released. The API did not provide `serial_age_s`, so this window establishes continuity of snapshots, not a measured serial-link age.

At 04:43 Asia/Manila, I derived ZYX Euler angles from the last 120 live pointer matrices spanning 59.5 minutes. Unwrapped yaw changed +652.7° (+10.97°/min); roll spanned 0.00°, pitch spanned 0.10°, and yaw advanced in 119 of 119 sample intervals, with a 6.2° 95th-percentile step per 30-second interval. If the pointer was physically still, this pattern is consistent with residual yaw drift; the telemetry has no independent pose or stillness proof, so it does not justify recalibrating the valid stored offsets. With zero accepted ArUco poses and no head stream, the system currently has no absolute heading correction.

At 04:46 Asia/Manila, a read-only V4L2 query showed the active camera mode advertises 640×480 MJPEG at 30 fps, and the driver reports a 30 fps time-per-frame setting; the in-use counter remains about 15.3 fps while each blocking read takes about 63 ms. Together with the near-black frame, this points to exposure/scene brightness limiting actual capture cadence rather than an unsupported camera mode. No exposure controls were changed; uncovering the lens and adding light is the next discriminating action.

At 04:47 Asia/Manila, systemd reported `auris.service` active/running with `NRestarts=0`, last activated at 02:24:31, and `Restart=always` with a two-second retry delay. This confirms continuous service-process uptime across the observed bring-up window; the systemd user journal contains no entries because this unit does not write logs there.

At 05:14 Asia/Manila, I replaced the Pi's served 3d/viz.js with the LF-normalized workspace version after finding the deployed file differed by stray blank lines; its SHA-256 now matches the workspace at 416f1a12574c224e06799b747f59d12a19785353e2757db327efa3d5a552c0cd. The Pi-local page served the yaw-change card and cache key, /health returned 200 ok, and /state reported live pointer data (mock: false, ToF 1.853 m), no fresh head sample, 154,433 camera frames, zero accepted detections, zero read failures, and `assumed-fov` calibration. The public quick tunnel returned HTTP 200 for both /health and /state and its state was also real (mock: false, ToF 1.854 m), with no fresh head sample and zero detections. `auris.service` and `auris-tunnel.service` remained active; read-only telemetry watcher PID 208050 had run 6,450 seconds of its eight-hour window. No sensor service was restarted.

At 05:18 Asia/Manila, a read-only sample from the Pi's annotated /camera stream decoded to 640×480 with mean grayscale brightness 0.47/255 (minimum 0, maximum 163); /state still reported zero accepted ArUco poses and zero frame-read failures. The latest 120 in-use watcher snapshots span 59.5 minutes: pointer-matrix yaw changed +675.4° (+11.35°/min) in 119 of 119 intervals, roll and pitch each spanned 0.1°, and ToF ranged from 1.849 to 1.860 m. This pattern is consistent with yaw drift if the pointer stayed still, but the log cannot prove stillness or independent pose, so I left its valid calibration unchanged. Near-black brightness cannot distinguish a covered lens from a very dark scene.

At 05:20 Asia/Manila, I renewed the eight-hour read-only watcher and public quick tunnel so both cover the requested sleep window; the new watcher PID is 605423, appending to the existing JSONL history through about 13:20, and the new temporary phone link was verified separately in the operator session. The Pi-local sensor service remained active without restart. The new public link returned HTTP 200 for /health, /state, and /; the page includes the yaw-change card and cache key, while the live API reports mock: false, ToF 1.854 m, no fresh head sample, 161,768 camera frames, and zero accepted ArUco poses.

At 05:25 Asia/Manila, a fresh poll confirmed the restarted recorder was alive as PID 605423 and had appended through UTC 21:25:25. The Pi's local health endpoint returned HTTP 200; the live state remained real (`mock: false`) with pointer ToF 1.854 m, head freshness false, 166,287 camera frames, zero accepted detections, and zero frame-read failures. The camera calibration source is still `assumed-fov`, so no metric camera-derived cube position is available.
At 05:29 Asia/Manila, the active Pi unit configuration was confirmed as `--pointer-source serial`, `--head-source none`, and `--baud 115200`, using one CP2102 USB serial device; the Pi enumerates the Sunplus camera and one CP2102, with no second serial interface. The live endpoint continues to carry pointer/ToF data, while the head reader is explicitly disabled. The pointer firmware documentation defines a 115200-baud USB debug table, whereas the compute-unit bridge stream carrying `P1` and `H1` is 460800 baud, so the current feed is consistent with direct pointer-table mode and does not demonstrate the bridge/H1 path; the CP2102 identity alone cannot distinguish which board is connected. I left the active baud and service command unchanged to protect the working pointer feed. The Pi deployment checkout at `/home/user/Projects/system` contains existing modified and untracked source files and has its own compute-unit instructions; I preserved that dirty tree and left the desktop `cu/` placeholder untouched.
At 05:38 Asia/Manila, both `auris.service` and `auris-tunnel.service` were still active and the eight-hour watcher PID 605423 was running. The live endpoint remained `mock: false`, with ToF 1.855 m, no fresh head sample, camera frame counter 177,394, zero accepted poses, zero read failures, and `assumed-fov` calibration. I compared the active service's `DICT_6X6_250` setting with the deployed camera module and Pi instructions, which describe `DICT_APRILTAG_36H11`; the earlier phrase “6x6 family” does not identify which generated dictionary was printed. Testing five saved frames from the 05:18 camera probe under both dictionaries found no IDs, but those frames were almost entirely black, so that result cannot distinguish a family mismatch from the marker not being visible. I left the dictionary unchanged until the cube face is visible in bright light.
At 05:39 Asia/Manila, a fresh one-second camera probe remained nearly black: the first 640×480 frame had mean luma 0.48/255, median 0, 99th percentile 2, and maximum 155. Five sampled frames produced no IDs under either configured `DICT_6X6_250` or `DICT_APRILTAG_36h11`; this confirms the current stream provides no usable tag observation, but does not identify whether the camera is covered, aimed away, or underlit. I made no exposure changes.
At 05:42 Asia/Manila, the last 120 watcher samples spanning 59.0 minutes show pointer-matrix yaw +636.2° (+10.77°/min), positive in all 119 intervals, with 0.1° roll/pitch spans and ToF 1.849–1.860 m. The 45 samples since the 05:20 recorder restart span 22.0 minutes and show +222.6° (+10.12°/min), positive in all 44 intervals, roll/pitch spans of 0.0°, and ToF 1.850–1.858 m. The repeated yaw-only trend with nearly fixed range and tilt is strong evidence of residual yaw drift if the pointer remained physically still, but telemetry has no independent stillness measurement; I did not alter the stored calibration.
At 05:44 Asia/Manila, I opened the camera route through the renewed public tunnel: it returned HTTP 200 as `multipart/x-mixed-replace` and delivered valid JPEG frames. This confirms the phone-accessible page's camera endpoint is the Pi stream, alongside the real `/state` API; the frame content remains nearly black, so it currently shows no usable cube pose.
At 05:50 Asia/Manila, I tried a reversible live-camera brightness correction. Before the change, V4L2 reported brightness 0, auto-exposure mode 3 (aperture priority), and exposure-time control 313; I changed brightness alone to 48 and left automatic exposure untouched. A one-second `/camera` sample shifted mean luma from 0.47 to 25.32/255, median from 0 to 23, 99th percentile from 2 to 48, and maximum from 166 to 185. The live capture counter continued, read failures remained zero, and the detector still found no tag IDs. I left brightness at 48 for the current session to make the feed more informative, but did not persist it across reboots without a visible marker to judge the effect.
At 05:56 Asia/Manila, I added `3d/camera_luma_watch.py` to record one frame's brightness every five minutes without retaining images, documented it in `3d/AGENTS.md`, and deployed the LF-normalized file to `/home/user/Projects/3d` with a matching SHA-256. The read-only watcher is PID 737770 and is scheduled to run through about 13:20, alongside the sensor-state recorder. Its first 640×480 sample measured mean luma 25.38/255, median 23, p99 48, and maximum 181 with the temporary brightness 48 setting; it successfully decoded a 9,214-byte JPEG and recorded no image data.

At 06:04 Asia/Manila, I added `3d/analyze_telemetry.py` to turn the overnight JSONL snapshots into a compact Markdown report with sensor availability, range, camera frame and processing counters, scene brightness, and pointer aim-azimuth trend. The logs append across sessions, so I added an inclusive `--since-utc` filter to keep this run's report separate from older rows. It labels yaw change as conditional on the pointer having remained physically still and states that these low-rate operational snapshots do not establish tracking accuracy or study latency. I am deploying it on the Pi and scheduling a one-time report after both recorders finish, without changing the live sensor service.

At 06:10 Asia/Manila, the filtered preliminary report covered 99 samples across 49 minutes with zero poll errors, pointer orientation in all rows, ToF at 1.85–1.86 m, no fresh head IMU or accepted camera pose, and camera capture at an estimated 15.32 fps with zero reported frame-read failures. It showed pointer aim azimuth changing +493.5° (+10.07°/min), which remains conditional on physical stillness, and three camera-brightness samples at mean luma 25.38–25.39/255. A user-level systemd timer is scheduled for 13:24:51 Asia/Manila to regenerate the report after both recorders' 13:20 stop time; the sensor and tunnel services remain active.

At 06:12 Asia/Manila, I refined the report to label malformed-line counts as full-file counts even when the data rows are time-filtered, excluded boolean values from detected marker IDs, and redeployed the final analyzer. The local and Pi copies have matching SHA-256 `c855af22bbb7984d9adb5330da437ee1202e54fe14cf99f368b735867826fcaa`; a refreshed filtered report ran successfully, both `auris.service` and `auris-tunnel.service` remained active, and the one-shot report timer still points to 13:24:51 Asia/Manila.

At 06:15 Asia/Manila, I checked the current camera stream and compute-unit interfaces without reopening the camera device. One 640×480 frame had mean luma 25.41/255, median 23, p99 48, and maximum 178; OpenCV found no IDs in the raw image or after gain/CLAHE under either `DICT_6X6_250` or `DICT_APRILTAG_36h11`. The USB bus shows the camera and one CP2102 serial device, while `/dev/i2c-1` scanning found no MPU6050 at `0x68` (only an unrelated device at `0x2d`). The live unit is explicitly configured with `--head-source none`, so the head IMU is not reaching the active pipeline; I left its working pointer serial mode unchanged because the single CP2102 identity does not tell me which ESP32 is attached.

At 06:39 Asia/Manila, I implemented camera-driven yaw re-anchoring in the Pi checkout. Each distinct fresh camera pose now derives the pointer-to-head IMU yaw offset from the head orientation, camera-observed cube rotation, and pointer orientation; while a pose is fresh, camera rotation still directly controls the beam, and the updated offset carries IMU orientation through tag loss. A tilted-head/tilted-pointer `[SIM]` recovered a 73° yaw offset with zero matrix residual, and both modified Python files parsed successfully. I restarted `auris.service` to load the change: `/health` returned `ok`, `/state` remained `mock:false` with pointer ToF at 1.855 m, camera frames advancing, and zero frame-read failures. No camera pose was available, so the new hand-off has not yet been exercised against a visible physical tag. The overnight recorders and tunnel remain active, and the final report timer remains set for 13:24:51 Manila time.
At 07:03 Asia/Manila, I propagated the decoded pointer stream identity and freshness through the Pi pipeline into /state and the live dashboard: the endpoint reports source usb-table, parser schema p1, pointer IMU and ToF freshness true, sample age 0 ms, and head input source none. The mobile dashboard now exposes the configured head input and pointer stream freshness. I deployed the workspace index.html and viz.js to the Pi, restarted auris.service, and verified the temporary public URL returns HTTP/2 200 for /, /health, /state, and /viz.js. I added HEAD handling after curl -I returned 501; those checks now return 200. The refreshed read-only telemetry recorder is PID 974986 and appends the source, schema, freshness, and age fields to the existing log through 13:20 Manila time. Camera frames continue with zero accepted ArUco tags and zero read failures. The temporary tunnel and the one-shot report timer remain active through 13:19:55 and 13:24:51 Manila time respectively.
At 07:09 Asia/Manila, the refreshed report summarized 12 snapshots over 5.5 minutes with zero poll errors: every row identified the USB debug-table source and p1 parser schema, pointer IMU/ToF flags were fresh in all rows, and sample-age p95 was 16.3 ms. The head input remained configured as none; the camera produced an estimated 15.35 fps with zero accepted detections and zero read failures. Pointer aim azimuth changed +56.8° over the short window, a drift interpretation remains conditional on physical stillness, and this bring-up log is not study evidence. The deployed page now names the source as USB debug table, reports the decoded row schema when distinct, and public HEAD checks for /, /health, /state, and /viz.js return HTTP/2 200.
At 07:31 Asia/Manila, the dashboard and /state now expose raw pointer acceleration, gyro availability, IMU die temperature, ToF status and measurement age, plus the configured marker dictionary, target IDs, tag edge and cube edge. A live snapshot reports USB debug table / p1 schema, fresh pointer IMU and ToF, 0.2 ms serial-row age, 31 ms ToF measurement age, ToF status 0, accelerometer [-0.82, 0.46, 1.41] g, no gyro vector or temperature in this stream, and camera configuration DICT_6X6_250 with IDs 11,10,8,7, 30 mm tags and a 50 mm cube. The camera is advancing frames with zero detections and zero read failures; the exact printed 6x6 dictionary variant remains unconfirmed, so the 250-entry selection is visible and is not treated as a successful marker lock. I aligned the camera CLI default and Pi instructions with the active runtime dictionary, and the overnight recorder was restarted as PID 1085028 through 13:20 with the raw sensor and detector configuration fields. Loopback, Ethernet 192.168.77.2, Wi-Fi 192.168.68.59 and the temporary public URL all return health ok; public HEAD checks return 200 for the page and multipart camera stream.
At 07:38 Asia/Manila, the pointer calibration bit is now visible in the dashboard and the new recorder. The live USB-table sample reports calibrated=true and flags 0x0f, which the firmware defines as calibration valid, IMU fresh, ToF fresh, and link up. The refreshed report currently has one known calibration row, zero gyro vectors in seven USB-table rows, accelerometer norm p50/p95 1.69/1.70 g, ToF status 0 with measurement-age p95 84.3 ms, and detector config DICT_6X6_250 with the expected IDs and physical dimensions; camera detections remain zero and the head input remains none. The 1.69 g norm is recorded as an observation, not a fault diagnosis or proof of stillness. The updated public dashboard still returns HTTP/2 200, and recorder PID 1111498 is collecting through 13:20 Manila time.
At 07:40 Asia/Manila, I added the pointer firmware calibration bit and raw flag byte to /state, the dashboard, and the overnight recorder. The live pointer reports calibrated=true, flags 0x0f, IMU and ToF fresh, and ToF status 0; the refreshed report sees the new calibration field while older rows remain unknown. The camera configuration and zero-detection state are unchanged. The public tunnel would have expired five minutes before the final report, so I changed its configured RuntimeMaxSec from 8 h to 10 h and reloaded systemd without restarting cloudflared: PID 605431 and the existing URL remain active until 15:19:55 Manila time, covering the wake and report window.
At 2026-11-07 08:03 Asia/Manila, I replaced the Pi marker solver single-branch choice with reprojection scoring across all planar-square candidates, rejecting solutions with non-forward camera depth. [SIM] Exact front, yawed, and tilted poses stayed within 0.006 rotation-matrix norm and a generated 30 mm ID 11 marker solved at 0.045 px RMS; all four cube-face transforms recovered the same cube orientation and center with zero algebraic residual. I restarted auris.service and confirmed loopback health HTTP 200, public health ok, and public /state source usb-table with schema p1, pointer IMU and ToF fresh, calibration true and flags 0x0f. Camera capture continues at 640×480 with zero read failures and zero marker detections; head source remains none. The telemetry and camera-luma recorders plus the one-shot report timer remain active.
At 2026-11-07 08:07 Asia/Manila, I hardened the Pi pose solver for planar ambiguity: it now uses solvePnPGeneric candidates, keeps only positive-depth solutions whose printed-face normal points toward the camera, and selects the lowest reprojection error. [SIM] Exact front-facing, yawed, tilted, and combined orientations recover within 0.006 matrix norm; a generated 30 mm marker ID 11 gives 0.045 px RMS. The service was restarted after the final edit and loopback /state plus public /health recovered; the live pointer remains source usb-table / schema p1 with calibrated=true, flags 0x0f, and fresh IMU and ToF. Camera detections remain zero with head source none.
At 2026-11-07 08:17 Asia/Manila, I extended the temporary tunnel to a 12-hour runtime and forced Cloudflare HTTP/2 after its automatic transport left the replacement tunnel without a published hostname. The tunnel service now has a registered connection and a new temporary hostname, stored in the operator session; it expires at 20:15:53 Manila time. I verified HTTP 200 for the public page, health, state, JavaScript, and camera multipart route; public state reports mock=false and the real USB pointer stream. The previous public hostname rotated and is no longer current.
At 2026-11-07 08:21 Asia/Manila, I extended the read-only bring-up window to match the requested sleep: telemetry and camera-luma recorders are systemd-managed through 16:19:37, writing to the existing JSONL files without storing camera images. A second one-shot analyzer is scheduled for 16:35 Manila time and will write /home/user/auris-bringup-report-wake-20261107.md. All four active units are confirmed; the latest recorded state still reports real usb-table data, no camera detections or frame-read failures, and head source none.
At 2026-11-07 08:30 Asia/Manila, I corrected the dashboard low-light heuristic: its old mean-luma threshold of 12/255 called the live camera sample around 27/255 normal despite zero tag detections. The warning now triggers below 40/255 and is explicitly an operator hint, not a marker-quality claim. I updated the workspace docs and deployed the JavaScript to the Pi; node --check and git diff --check pass, and the public /viz.js response contains the new threshold.
At 2026-11-07 08:32 Asia/Manila, the latest Pi camera-luma sample is 29.0/255 mean, 24 median, and 51 p99 at 640×480; with the new 40/255 browser heuristic this will be shown as low brightness on a fresh dashboard load. Live /state remains mock=false with source usb-table and fresh pointer IMU/ToF; camera detections and read failures are still zero, head source none, and the public health route returns ok.
At 2026-11-07 08:52 Asia/Manila, I tested the installed bridge-mode serial settings against the attached Pi hardware and immediately restored the working service: the sole CP2102 port emitted readable 12-column pointer-table rows at 115200 baud, while 460800 produced undecodable bytes and no P1/H1 rows. The dashboard returned to `source=usb-table`, fresh pointer IMU and ToF, and zero camera read failures after restart; the head input is still `none`. The Pi exposes `/dev/serial0` as `ttyAMA10`, but the Linux serial console and `serial-getty@ttyAMA10` own it, so I did not redirect it. Pi I²C bus 1 still has no response at `0x68`/`0x69`; bus 13/14 scan results are broad and unsuitable for identifying a sensor. Camera gain 16 and 32 both left mean image luma near 31/255, so I restored gain to 0; exposure remains auto at 31.3 ms. The dashboard now uses a new `viz.js` cache key so clients fetch the low-brightness warning and the explicit disabled-head status on reload.
At 2026-11-07 09:00 Asia/Manila, I made the live camera card expandable on phone and desktop, with an accessible expand/shrink control and Escape-to-close, so the user can inspect marker visibility at a useful size. I deployed the updated HTML and JavaScript to the Pi and bumped the script cache key to `20261107-camera-preview`; browser syntax parsing passed locally. The pointer service and both LAN plus temporary public health routes remain active; marker detections are still zero, and the head input still needs its physical data path identified.
At 2026-11-07 09:05 Asia/Manila, a filtered 45.5-minute operational report contained 92 valid `/state` snapshots: 88 pointer rows all had fresh IMU and ToF, median/p95 sample age 0/36.4 ms, range 1.85–1.86 m, and calibrated flags `0x0f`; head freshness and camera-pose freshness were zero, with 15.31 estimated camera FPS, zero detections, zero read failures, and 61.01/62.96 ms p50/p95 camera read time. Ten camera-luma samples ranged 28.20–31.84/255, plus one undecodable-frame event; the separate report is operational telemetry, not evidence of tracker accuracy. The only two `/state` poll errors were at 00:39:37 and 00:40:07 UTC during the deliberate serial-mode restart; subsequent snapshots recovered. `auris.service` is enabled and user linger is on, while `auris-tunnel.service` is active only as a static manually started unit with a 12-hour lifetime, so its temporary hostname will not persist across reboot.
At 2026-11-07 09:22 Asia/Manila, I raised the live camera brightness from 48 to 96 and measured 640×480 stream luma at mean 88.5/255, p99 114/255, and maximum 199/255; the service stayed at zero camera read failures but still reported zero marker detections, so this improves operator visibility without establishing that the cube is in view or that tracking works. I added an ExecStartPre V4L2 command to auris.service and restarted it; brightness 96, real usb-table pointer IMU/ToF, the dashboard HTTP 200 routes at 192.168.68.59:8081 and 192.168.77.2:8081, and camera capture all survived normal startup. The Pi enumerates one CP2102 adapter, whose active stream is the legacy pointer table; head source remains none and there are no H1 samples, so the adapter alone does not establish which ESP32 board is attached. I restarted eight-hour sensor and camera-luma recorders through about 17:22 Manila and retained the 17:35 wake report; these are operational observations, not study evidence.
At 2026-11-07 09:33 Asia/Manila, I restored the PC Ethernet view by starting the local-only proxy at http://127.0.0.1:8781/, which routes from Windows 192.168.77.1 to Pi 192.168.77.2:8081; its health response is ok and its state is mock=false with fresh pointer IMU and ToF. The live camera marker decoded as ID 11 in eight consecutive frames under DICT_APRILTAG_36H11 and produced no IDs under DICT_6X6_250, so I changed the Pi service and integrated camera defaults to DICT_APRILTAG_36H11 and aligned the Pi instructions. The restarted pipeline reported 779 detections in 812 frames, current marker ID 11, a fresh 0.440 m camera pose at [0.429, 0.067, -0.070] m in the head frame, 0.357 px reprojection error, camera-derived baseline, and zero camera read failures; this is an operational stream observation, not a study accuracy measurement. The separate head IMU stream remains disabled because no H1 samples are arriving.
At 2026-11-07 09:52 Asia/Manila, after the camera-service restart the PC Ethernet proxy and public temporary tunnel both return current mock=false state. Reloading the PC dashboard reconnected its MJPEG stream; the image now shows a green ID 11 box and cube-centre range in agreement with VISION LOCKED and TAG LOCKED, while the preview now labels a fresh held pose instead of claiming no tags during a one-frame miss. The latest snapshot has frame 7411, detection counter 6927, current marker ID 11, pose age 86 ms, camera position [0.429176, 0.067197, -0.070494] m in the head frame, 0.356626 px reprojection error and zero camera read failures; pointer IMU and ToF are fresh, while the head source remains none. The 8-hour sensor and luma recorders are active until about 17:22 Manila, a report for that exact window is scheduled at 17:30, and the broader bring-up report is scheduled at 17:46. These are operational stream observations, not study accuracy evidence.
At 2026-11-07 09:56 Asia/Manila, I briefly enabled the H1 serial parser at the working 115200 baud; no head sample arrived, while the pointer USB table remained fresh, so I restored head-source none. After restart the camera continued delivering frames with zero read failures but no marker detections, and the live page showed SEARCHING with pointer IMU/ToF still fresh; the current camera stream simply has no accepted tag observation. The configured AprilTag 36h11 dictionary, brightness 96, Ethernet proxy, and scheduled 8-hour recorders remain active. This source check and camera state are operational observations, not study evidence.
At 2026-11-07 10:17 Asia/Manila, I changed the dashboard's top tracking badge so pointer data counts as live only when both IMU and ToF freshness flags are true and any reported sample age is at most 250 ms; stale and unreported pointer freshness is now explicit, and a vision lock requires fresh pointer and camera inputs. I synchronized the complete workspace `viz.js` to `/home/user/Projects/3d/viz.js` with an LF-normalized SHA-256 of `bb38fd44354cb1ad2b3def60c3675a152a4e2216a04a454b12a932fcc1060d3f`, updated the page cache key, and confirmed the served script hash and `/health` response. The Pi endpoint remains real (`mock: false`), pointer IMU and ToF are fresh, head IMU freshness is false, the camera has 18,899 frames with zero accepted marker IDs and zero read failures, and `auris.service` is active. I restarted the Windows Ethernet proxy and confirmed its local `/health` route returns HTTP 200; these are operational observations, not tracker-accuracy or study-latency evidence.
At 2026-11-07 10:31 Asia/Manila, the current Chrome dashboard showed the camera in `SEARCHING`, brightness 182.8/255, 15.3 fps, 54.2 ms read time, 7.6 ms detection time, zero hits, and zero read failures; the subsequent Pi snapshot still had zero detections and zero failures, with read/detection times 20.5/12.8 ms. V4L2 lists 640×480 MJPG and YUYV modes at 30 fps and reports a configured 30 fps, but the pipeline's observed rate is lower and I left capture settings unchanged because there is no marker in view to judge detection quality. At 10:35, brightness control was 96, auto-exposure mode was aperture priority with a 31.3 ms exposure, and gain was 0; the audition process used 78% of one CPU, Pi temperature was 57.6 °C, `throttled=0x0`, and 7.1 GiB memory was available, so thermal throttling was absent. The Pi enumerates one CP2102 serial adapter and `auris.service` currently runs at 115200 baud with `head-source none`; its live source is `usb-table`, while the documented bridge contract is interleaved `P1`/`H1` at 460800 baud. A prior 460800 probe on this adapter produced undecodable data, so I preserved the working pointer feed rather than retuning an ambiguously identified device. This narrows the remaining head-input issue to identifying the active USB board/firmware and restoring the bridge `H1` stream; the camera needs a tag back in view before its current lock can be assessed. Operational observations only, not tracker-accuracy or study-latency evidence.
At 2026-11-07 10:40 Asia/Manila, an interim report covering 78 minutes contained 168 valid state snapshots and zero poll errors; pointer IMU and ToF were fresh in all 168 snapshots with sample-age p50/p95 of 0/37.6 ms, while head IMU freshness was zero. The camera ran at an estimated 15.30 fps with zero read failures; a fresh pose appeared in 47/168 snapshots and ID 11 was observed earlier in the window, but the latest state had no IDs and detection counter zero. Frame/detection counters dropped 4/2 times, with detection count peaking at 10,850 before resetting; the luma samples ranged 88.52–185.77/255. I updated and deployed `analyze_telemetry.py` to report latest and peak detection counters, counter drops, IDs seen in the window, and latest IDs separately, so a service restart does not hide prior detections. These remain operational observations, not tracking-accuracy or study-latency evidence.
At 2026-11-07 10:43 Asia/Manila, `auris.service`, both sleep-window recorders, and the temporary tunnel were active; `auris.service` is enabled and `Linger=yes`, so the user service starts without an interactive login. The PC loopback Ethernet proxy health route returned HTTP 200, and the public tunnel health route returned `ok`. The Pi continues to report real pointer USB-table data with fresh IMU/ToF, head source `none`, no current marker IDs, and zero camera read failures. The 17:30 sleep-window report and 18:11 follow-up report remain scheduled.
At 2026-11-07 11:02 Asia/Manila, I added a source-aware head-input diagnosis to the dashboard and deployed the page assets without restarting `auris.service`; the Pi's served `index.html` and `viz.js` SHA-256 hashes match the workspace files, `/health` is `ok`, and the temporary public page, `/health`, `/state`, and `/viz.js` routes return HTTP 200 with the new cache key and diagnosis. `/state` remains real (`mock: false`) with fresh pointer IMU and ToF from `usb-table` at 0 ms sample age, while head input is `none`/stale and the camera has 60,400 frames, zero current marker detections, and zero frame-read failures. The head card now explains that the active USB debug table carries no head `H1` records; this reports stream provenance and does not imply that the bridge is physically absent. No sensor setting or firmware was changed.
At 2026-11-07 11:09 Asia/Manila, I restarted only the read-only sensor and camera-luma recorders, extending their collection window to eight hours from 11:09:15; both recorder services are active. I added a final telemetry-summary timer for 19:15 Manila time, about six minutes after the requested eight-hour sleep window, while leaving the earlier interim reports scheduled. These traces describe operational stream health and do not measure tracking accuracy or study latency.
At 2026-11-07 11:12 Asia/Manila, Pi USB enumeration showed the head camera and one Silicon Labs CP210x UART device, with `/dev/ttyUSB0` as the only serial endpoint and no `/dev/ttyACM*`; the active endpoint continues to decode pointer `usb-table` rows, so no head `H1` records are present in that stream. The latest camera-luma row was 184.79/255 mean at 640×480; `/state` had 68,991 frames, zero accepted detections, zero read failures, fresh pointer IMU/ToF, and head source `none`. This establishes what Linux currently enumerates and receives, not which physical board is attached or whether the cube is in the camera's field of view; no serial mode, sensor setting, or firmware was changed.
At 2026-11-07 11:26 Asia/Manila, I restored the Windows loopback Ethernet proxy with `open_ethernet_view.ps1 -NoBrowser` using the authorized host network path; its `/health` returned `ok`, and 30 `/state` requests through `127.0.0.1:8781` returned real `mock: false` pointer USB-table data with fresh IMU/ToF. Their round-trip p50/p95/max was 3.44/35.57/43.00 ms, while the live dashboard rendered 32.2 updates/s with a 4.2 ms current fetch sample. This is an operational measurement rather than a study latency result; the Pi pipeline was not restarted. The Codex in-app browser's direct request to the Pi Ethernet address timed out, but the host proxy's selected Ethernet path works.
At 2026-11-07 11:44 Asia/Manila, `auris.service`, `auris-tunnel.service`, and the eight-hour telemetry and camera-luma recorder units are active with `Linger=yes`; the temporary public URL still returns `/health: ok`, and the final sleep-window summary timer is scheduled for 19:15. A live `/state` snapshot at 11:42 was real (`mock: false`), with fresh pointer IMU and ToF from `usb-table`, no head IMU sample, 96,877 camera frames, no current marker IDs or detections, and zero camera read failures; capture and detect times were 52.55 ms and 13.22 ms. A separate recent 640×480 frame review measured mean luma 184.69/255 (median 205, p99 254) and yielded eight rejected quadrilateral candidates but no recognized tags; the largest crop looked like a plain gray/dark rectangular surface, which describes that frame only and does not establish whether the cube was physically present. These are operational observations, not study accuracy or latency evidence.
At 2026-11-07 11:47 Asia/Manila, the Windows Ethernet proxy was no longer listening on port 8781, so I restarted it with `open_ethernet_view.ps1 -NoBrowser`; `/health` then returned HTTP 200 `ok`. Thirty `/state` fetches returned real data (`mock: false`), with fresh pointer IMU/ToF, stale head IMU, and an RTT p50/p95/max of 3.57/28.56/36.54 ms. The latest Pi recorder row at 11:47 still showed a live 640×480 camera feed, 101,783 frames, no current marker IDs, and zero read failures; capture/detection timing was 51.30/11.19 ms. The proxy restart did not restart the Pi sensor process, and this spot-check latency is operational rather than study evidence.
At 2026-11-07 11:51 Asia/Manila, an interim analysis of the eight-hour recorder's first 41.5 minutes found 84 valid state rows at a 30 s cadence with no poll errors. Pointer IMU and ToF were fresh in all rows, while head IMU and camera pose were fresh in none; the camera estimate was 15.30 fps, with zero detections, zero frame-read failures, read-time p50/p95 53.75/57.76 ms, and detect-time p50/p95 11.22/13.00 ms. Nine brightness samples stayed between 184.12 and 184.97/255 mean luma, so this interval does not support a low-light explanation for the absent tags; tag visibility still needs a direct in-person check. The pointer's fused orientation changed 585.9° over the 41.5 min window, but there is no independent motion reference, so this does not establish drift; raw gyro values were absent from all 84 rows and the reported accelerometer norm was 1.69–1.71 g. This interim summary is operational telemetry, not tracking-accuracy or study-latency evidence.
At 2026-11-07 12:01 Asia/Manila, the running Pi unit is configured for `--pointer-source serial --head-source none --baud 115200` on its only enumerated CP2102 serial endpoint, while live state labels the received pointer format `usb-table`. The checked-in bridge source defines 460800 baud and emits H1 head rows; its expected compiled image is absent from the usual build path. A previous 460800 probe could not decode the active stream, so I kept the working pointer feed and did not change the baud or flash firmware. This confirms a mismatch between the running serial contract and the checked-in bridge contract, but it does not identify which physical ESP32 or firmware is attached, nor prove the head sensor pin wiring. The pointer-side wiring documented in pointer/AGENTS.md connects GY-521 VCC to 3V3, GND to GND, SDA to GPIO21, SCL to GPIO22, and AD0 to GND on the 30-pin pointer DevKit V1; this does not establish the head IMU wiring or assign those pins to the 38-pin compute-unit bridge. The missing H1 stream still requires identifying which sensor board is attached to the Pi and how the head IMU reaches it before switching the serial configuration.
At 2026-11-07 12:33 Asia/Manila, I added the pointer AHRS body-to-filter-world matrix as pointer.matrix_pointer_inertial in the Pi /state API; it is row-major, keeps the pointer filter's zero-yaw frame unregistered to the head, and is diagnostic only with no effect on placement or audio. The three.js view now falls back to a pointer-local raygun and fresh ToF endpoint when no current camera pose, tracked displacement, or previous head sample supplies a shared frame; it hides the head and labels the arbitrary display origin and unregistered yaw. A previously seen but stale head reference remains explicitly labeled held. The coordinate label switches with the displayed frame. I deployed the page and module to /home/user/Projects/3d; SHA-256 hashes match the workspace, node --check and remote py_compile succeeded, and git diff --check is clean. After restarting only auris.service to load the API field, /health returned 200, /camera returned multipart MJPEG, and the active public temporary link returned 200 for /health, /state, and / with the new cache key. The PC Ethernet proxy is restored at http://127.0.0.1:8781/; 30 real /state fetches measured 4.15 ms p50, 26.65 ms p95, and 45.57 ms max. The verified snapshot had mock=false, fresh pointer IMU and ToF, matrix_pointer_inertial present, no fresh head sample, and zero accepted camera detections; service and eight-hour recorders remain active, and the public tunnel is scheduled through 20:15 Manila. These are operational software observations, not evidence of tracking accuracy or study latency.
At 2026-11-07 12:56 Asia/Manila, live ArUco detection is working on the Pi. The current real snapshot has pointer IMU and ToF fresh, front face ID 11, camera pose age 0.089 s, position_fresh=true, 29,869 captured frames, 5,398 accepted cube-pose detections, zero camera read failures, 0.246 px representative reprojection RMS, and assumed-fov calibration. The camera is configured for the four cube faces 11/front, 10/top, 8/left, and 7/right with 30 mm black-square tags on a 50 mm cube; camera.py transforms accepted face poses to cube centre and attitude before fusion. Only ID 11 was seen across the latest twenty 30 s recorder samples, so the other face transitions remain unverified. A 12 s live poll after restoring camera defaults measured 15.25 fps, 87 detection-counter increments, 0.103 s median and 0.308 s p95 detection gaps, and a 0.915 fraction of samples with pose age at most 250 ms; the prior 20-sample window had only 0.55 fresh rows, showing that visibility varies and the short poll is not a tracking-accuracy result. I tested gain 8, then manual exposure 200 with gain 16; neither raised capture cadence, the manual interval produced no detections, and the observed luma stayed near 87/255. I restored auto exposure mode 3, exposure value 313, gain 0, brightness 96, and dynamic-framerate control 0; the current v4l2 settings confirm those values. The Pi enumerates one CP2102 USB serial endpoint and decodes its active 115200-baud stream as the pointer firmware's 12-column USB debug table; no H1 head samples arrive. A targeted Pi I2C scan found no responder at MPU6050 addresses 0x68 or 0x69. This verifies that the head IMU is not currently reaching either configured input path, but does not establish its physical wire routing or identify the connected ESP32. Camera metric depth still uses assumed-fov rather than measured intrinsics. These are live operational observations, not evidence of pose accuracy or study latency.
