pewpil/auris/bench/t0/t0-power-rails.kicad_sch

## KiCad design bench/t0/t0-power-rails.kicad_sch (2026-09-28)

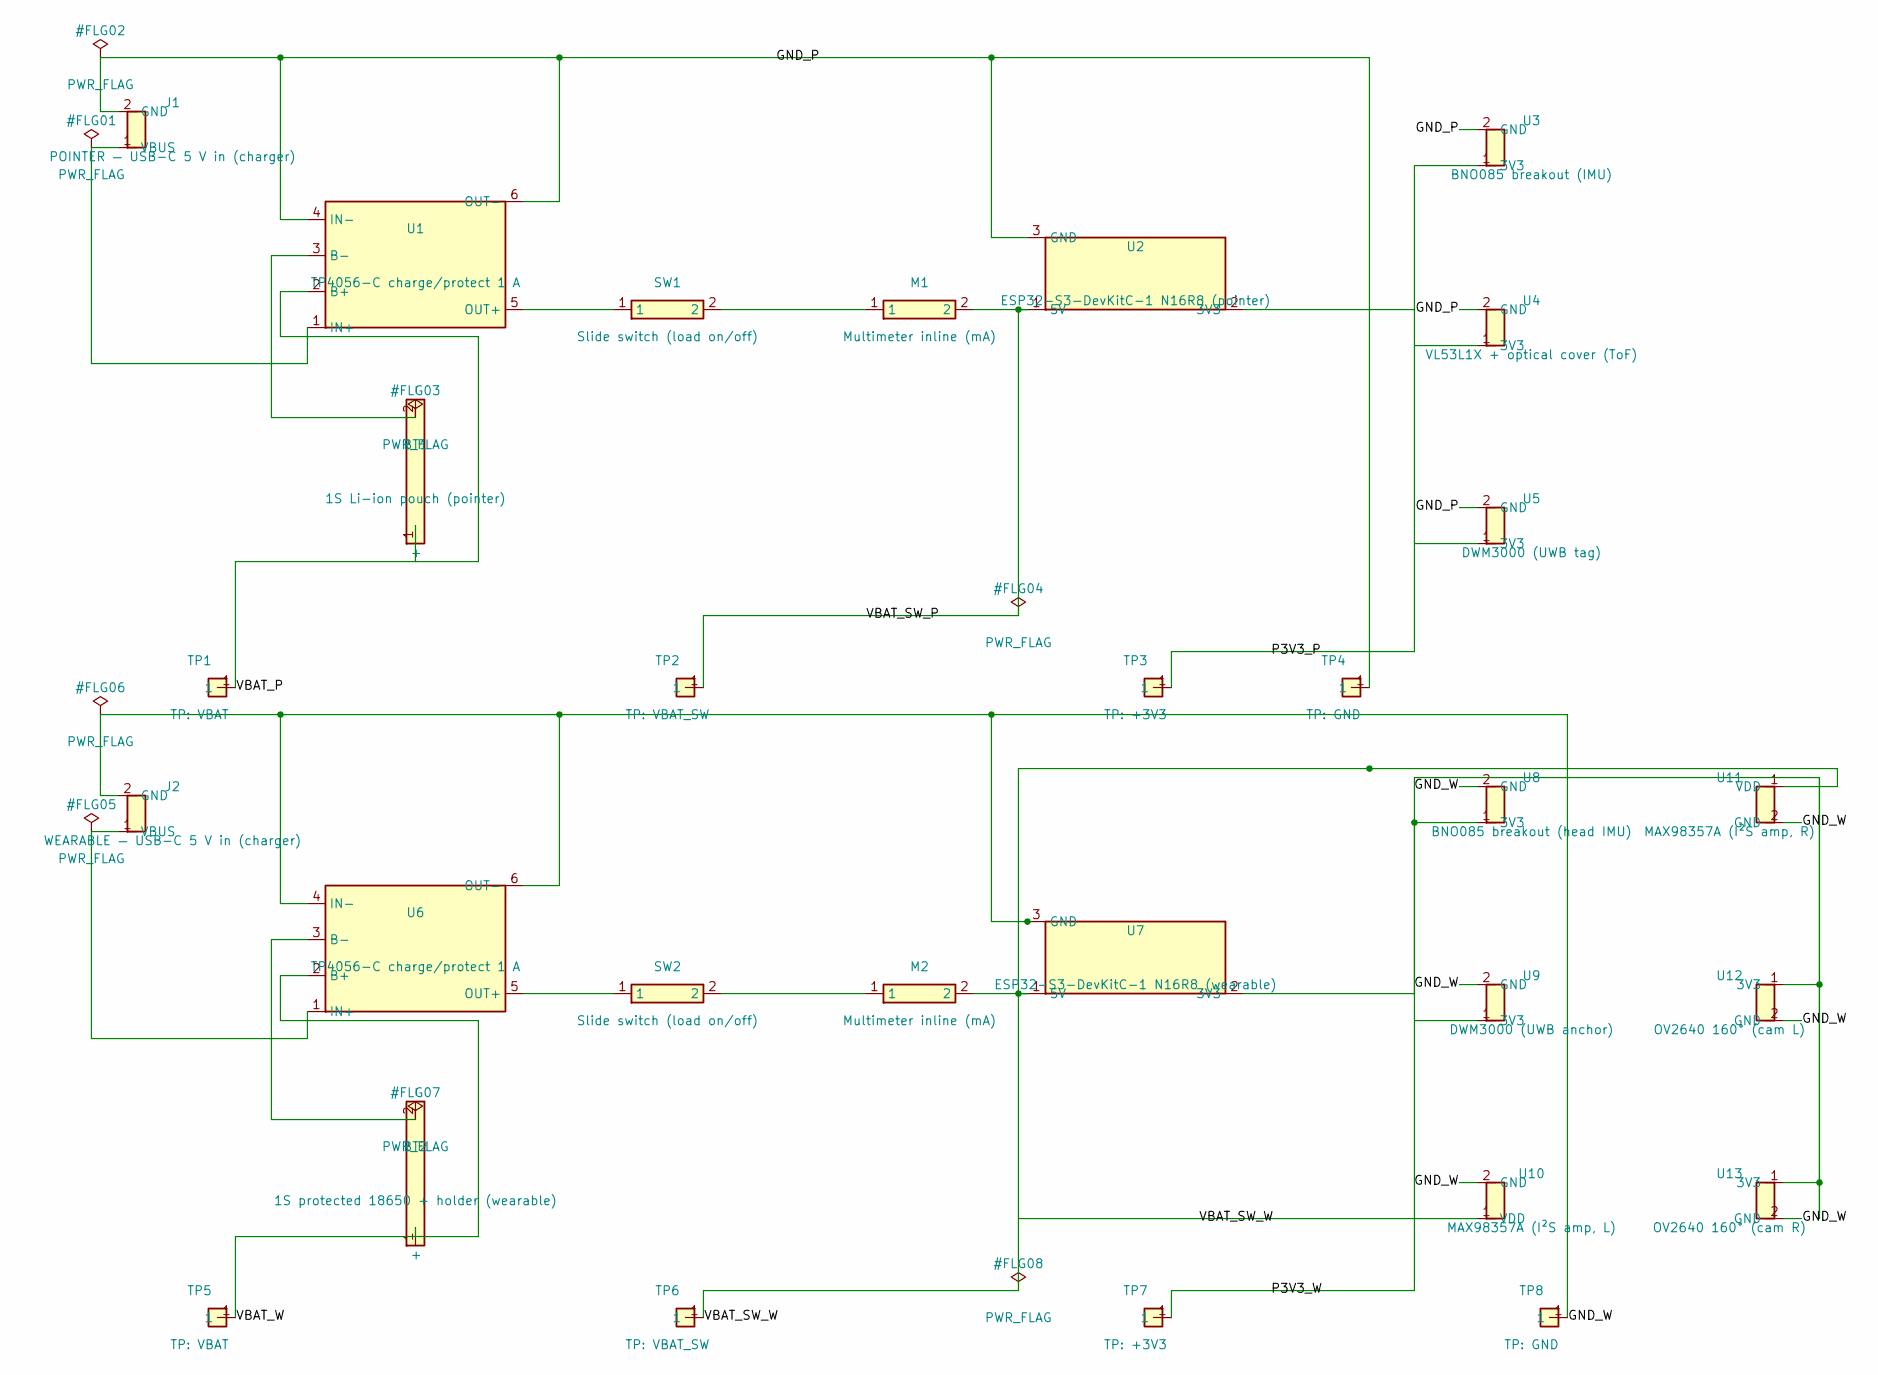
[picture p1: schematic t0-power-rails.kicad_sch]

Parts:
BT1: 1S Li-ion pouch (pointer)
BT2: 1S protected 18650 + holder (wearable)
J1: POINTER — USB-C 5 V in (charger)
J2: WEARABLE — USB-C 5 V in (charger)
M1, M2: Multimeter inline (mA)
SW1, SW2: Slide switch (load on/off)
TP1, TP5: TP: VBAT
TP2, TP6: TP: VBAT_SW
TP3, TP7: TP: +3V3
TP4, TP8: TP: GND
U1, U6: TP4056-C charge/protect 1 A
U2: ESP32-S3-DevKitC-1 N16R8 (pointer)
U3: BNO085 breakout (IMU)
U4: VL53L1X + optical cover (ToF)
U5: DWM3000 (UWB tag)
U7: ESP32-S3-DevKitC-1 N16R8 (wearable)
U8: BNO085 breakout (head IMU)
U9: DWM3000 (UWB anchor)
U10: MAX98357A (I²S amp, L)
U11: MAX98357A (I²S amp, R)
U12: OV2640 160° (cam L)
U13: OV2640 160° (cam R)

Connections:
GND_P: J1.2 (GND), TP4.1, U1.4 (IN-), U1.6 (OUT-), U2.3 (GND), U3.2 (GND), U4.2 (GND), U5.2 (GND)
GND_W: J2.2 (GND), TP8.1, U6.4 (IN-), U6.6 (OUT-), U7.3 (GND), U8.2 (GND), U9.2 (GND), U10.2 (GND), U11.2 (GND), U12.2 (GND), U13.2 (GND)
unnamed: BT1.2 (-), U1.3 (B-)
unnamed: BT2.2 (-), U6.3 (B-)
unnamed: J1.1 (VBUS), U1.1 (IN+)
unnamed: J2.1 (VBUS), U6.1 (IN+)
unnamed: M1.1, SW1.2
unnamed: M2.1, SW2.2
unnamed: SW1.1, U1.5 (OUT+)
unnamed: SW2.1, U6.5 (OUT+)
P3V3_P: TP3.1, U2.2 (3V3), U3.1 (3V3), U4.1 (3V3), U5.1 (3V3)
P3V3_W: TP7.1, U7.2 (3V3), U8.1 (3V3), U9.1 (3V3), U12.1 (3V3), U13.1 (3V3)
VBAT_P: BT1.1 (+), TP1.1, U1.2 (B+)
VBAT_SW_P: M1.2, TP2.1, U2.1 (5V)
VBAT_SW_W: M2.2, TP6.1, U7.1 (5V), U10.1 (VDD), U11.1 (VDD)
VBAT_W: BT2.1 (+), TP5.1, U6.2 (B+)
