pewpil/auris/(commit log)

2026-08-26 considered rgb cameras for production
2026-08-26 plan revision: prototype and production stages due to financial reason
2026-08-26 added existing discrete gpu and researcher 1 approval for prototype hardware components
2026-08-26 plan revision: prototype yolo compute needs consideration
2026-08-30 api token insert
2026-09-03 promotional site wireframe
2026-09-04 new concept update: 3d print specific wearable
2026-09-08 new concept wired
2026-09-08 new concept update: button on pointer
2026-09-08 dev plan rewrite for the pointer's button
2026-09-08 two imus distance question response
2026-09-10 development phase update: stages reverted back
2026-09-15 kicad integration
    [cane-pointer.kicad_sch, cane-wearable.kicad_sch]
2026-09-16 pointer-tracking tiers: beacon marker, P2/T7-T8 gates, ledger C11, UWB+VLP literature
2026-09-16 removed temporary electronics
    [cane-pointer.kicad_sch, cane-wearable.kicad_sch]
2026-09-16 dev plan update: strap, intereporable earphones
2026-09-25 new sets of hardware components and materials
2026-09-26 dev plan update: soldering service
2026-09-26 hardware components and materials itemized
2026-09-27 bench materials list
2026-09-27 kicad mcp setup
2026-09-27 kicad-happy agent skills added as .opencode/skills submodule
2026-09-27 bench/t0: power-rails schematic rebuilt clean
    [t0-power-rails.kicad_sch]
2026-09-28 bench t0
    [t0-power-rails.kicad_sch]
2026-09-29 hardware cleared again — components/materials pending dual-compatible re-selection (esp32-s3 + raspi-5)
2026-09-29 bench materials
2026-10-07 no pointer mcu pin and no artificial md lines return
2026-10-14 pointer firmware source code from old schematics
2026-10-14 imu test
2026-10-30 pointer sensor node button fix
2026-11-03 agent skills for both kicad and threejs
2026-11-07 Dashboard Prototype
